benvonhandorf/RX_EQ_Shield/RX EQ Shield.kicad_pcb

## KiCad design RX EQ Shield.kicad_pcb (2022-07-02)

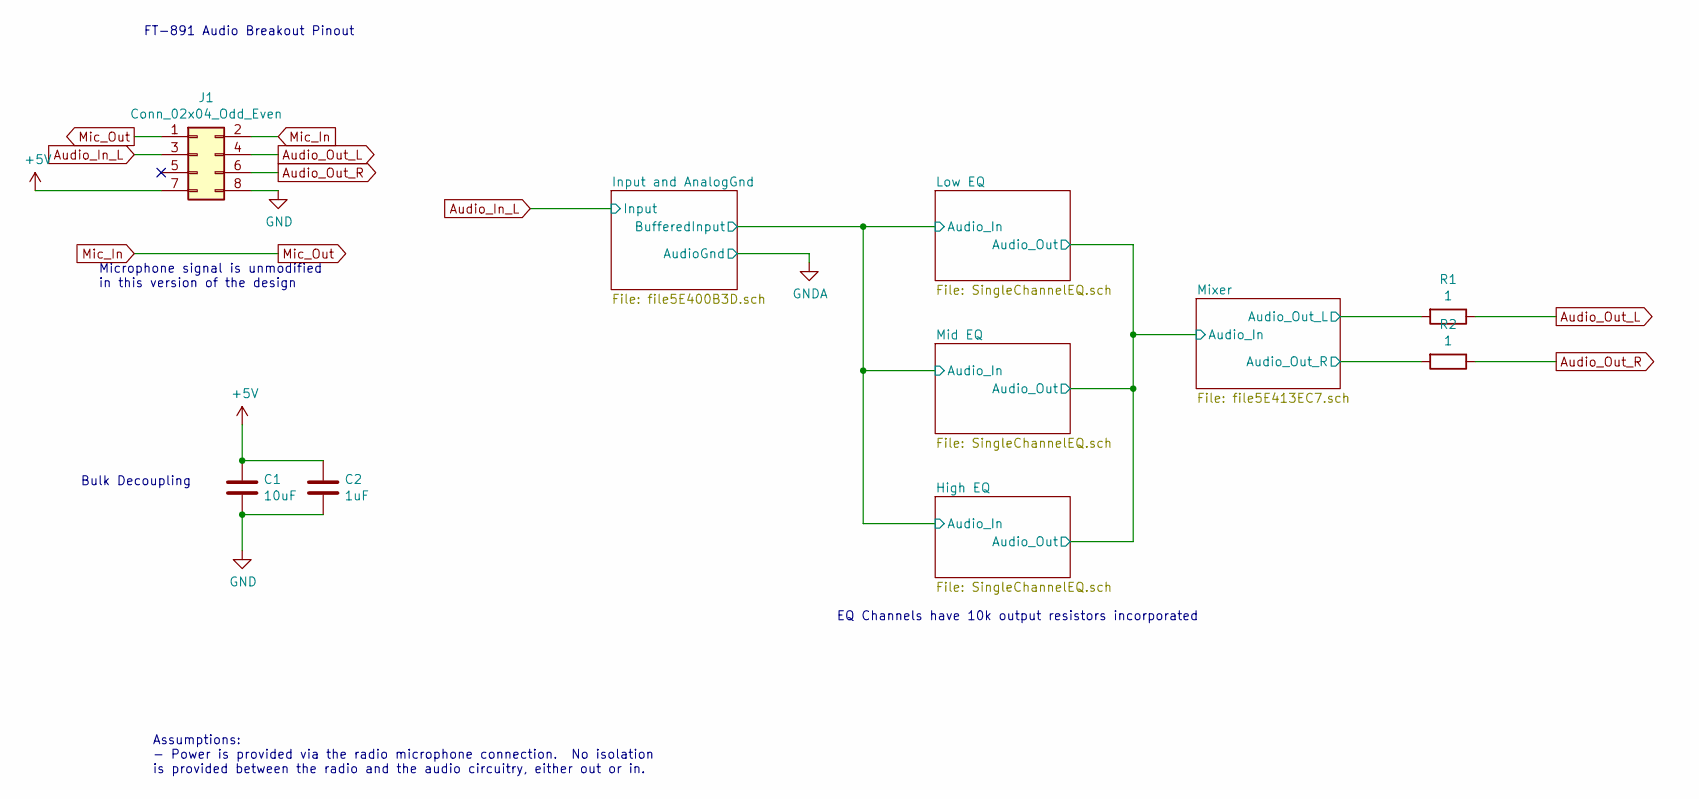
[picture p1: schematic RX EQ Shield.sch, FT-891 Audio breakout - 3 Band EQ Shield]

Parts:
C1: 10uF; C_0805_HandSoldering
C2: 1uF; C_0805_HandSoldering
J1: Conn_02x04_Odd_Even; Pin_Header_Straight_2x04_Pitch2.54mm
R1, R2: 1; R_0805_HandSoldering

Connections:
+5V: C1.1, C2.1, J1.7; also elsewhere on the board
Audio_In_L: J1.3; also elsewhere on the board
Audio_Out_L: J1.4, R1.1
Audio_Out_R: J1.6, R2.1
Mic_In: J1.1, J1.2

Notes on the sheet:
Bulk Decoupling
FT-891 Audio Breakout Pinout
Assumptions: - Power is provided via the radio microphone connection. No isolation is provided between the radio and the audio circuitry, either out or in.
EQ Channels have 10k output resistors incorporated
Microphone signal is unmodified in this version of the design

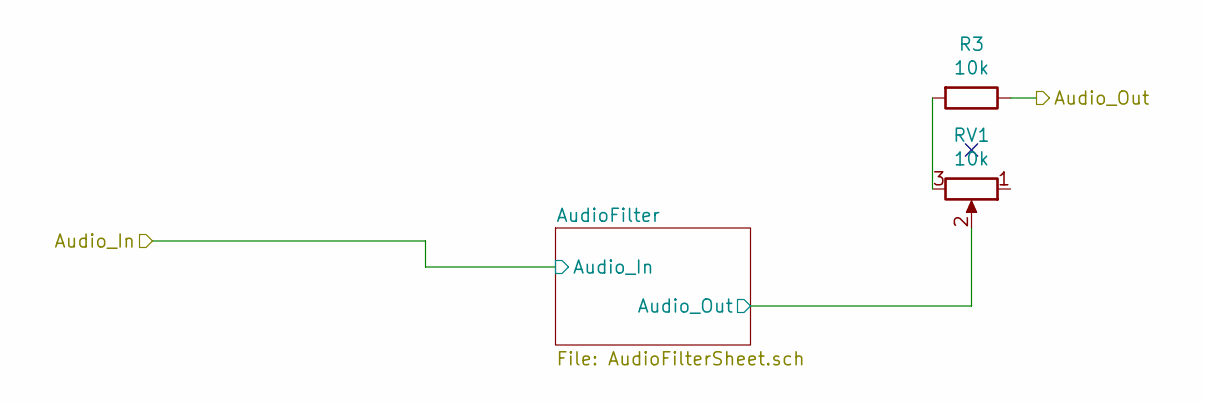
[picture p2: schematic SingleChannelEQ.sch, FT-891 Audio breakout - 3 Band EQ Shield]

Parts:
R3: 10k; R_0805_HandSoldering
RV1: 10k; Potentiometer_TT_P090S-Top-Adjust

Connections:
/Low EQ/AudioFilter/Audio_Out: RV1.2; also elsewhere on the board
/Mixer/Audio_In: R3.1; also elsewhere on the board
unnamed: R3.2, RV1.3

Parts of its further copies:
R7, R8: 10k; R_0805_HandSoldering
RV2, RV3: 10k; Potentiometer_TT_P090S-Top-Adjust

Connections of its further copies:
/High EQ/AudioFilter/Audio_Out: RV3.2; also elsewhere on the board
/Mid EQ/AudioFilter/Audio_Out: RV2.2; also elsewhere on the board
/Mixer/Audio_In: R7.1, R8.1; also elsewhere on the board
unnamed: R7.2, RV2.3
unnamed: R8.2, RV3.3

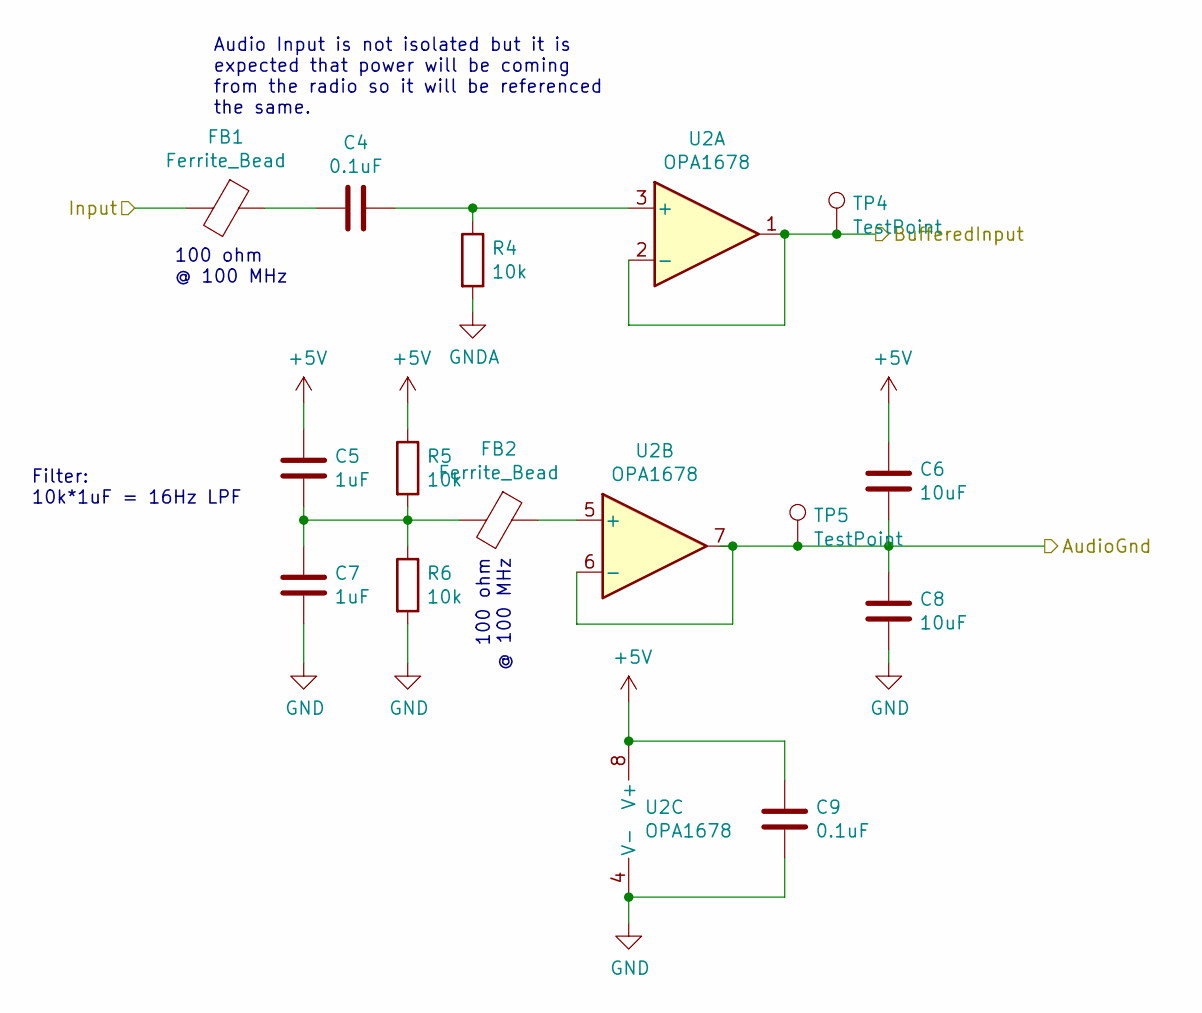
[picture p3: schematic file5E400B3D.sch, FT-891 Audio breakout - 3 Band EQ Shield]

Parts:
C4, C9: 0.1uF; C_0805_HandSoldering
C5, C7: 1uF; C_0805_HandSoldering
C6, C8: 10uF; C_0805_HandSoldering
FB1, FB2: Ferrite_Bead; L_0805_HandSoldering
R4, R5, R6: 10k; R_0805_HandSoldering
TP4, TP5: TestPoint; Test_Point_Keystone_5000-5004_Miniature
U2: OPA1678; SOIC-8-N

Connections:
+5V: C5.1, C6.1, C9.1, R5.1, U2.8 (V+); also elsewhere on the board
/High EQ/Audio_In: TP4.1, U2.1, U2.2 (-); also elsewhere on the board
Audio_In_L: FB1.2; also elsewhere on the board
GNDA: C6.2, C8.1, R4.2, TP5.1, U2.6 (-), U2.7; also elsewhere on the board
unnamed: C4.1, R4.1, U2.3 (+)
unnamed: C4.2, FB1.1
unnamed: C5.2, C7.1, FB2.2, R5.2, R6.1
unnamed: FB2.1, U2.5 (+)

Notes on the sheet:
Filter: 10k*1uF = 16Hz LPF
Audio Input is not isolated but it is expected that power will be coming from the radio so it will be referenced the same.
100 ohm @ 100 MHz

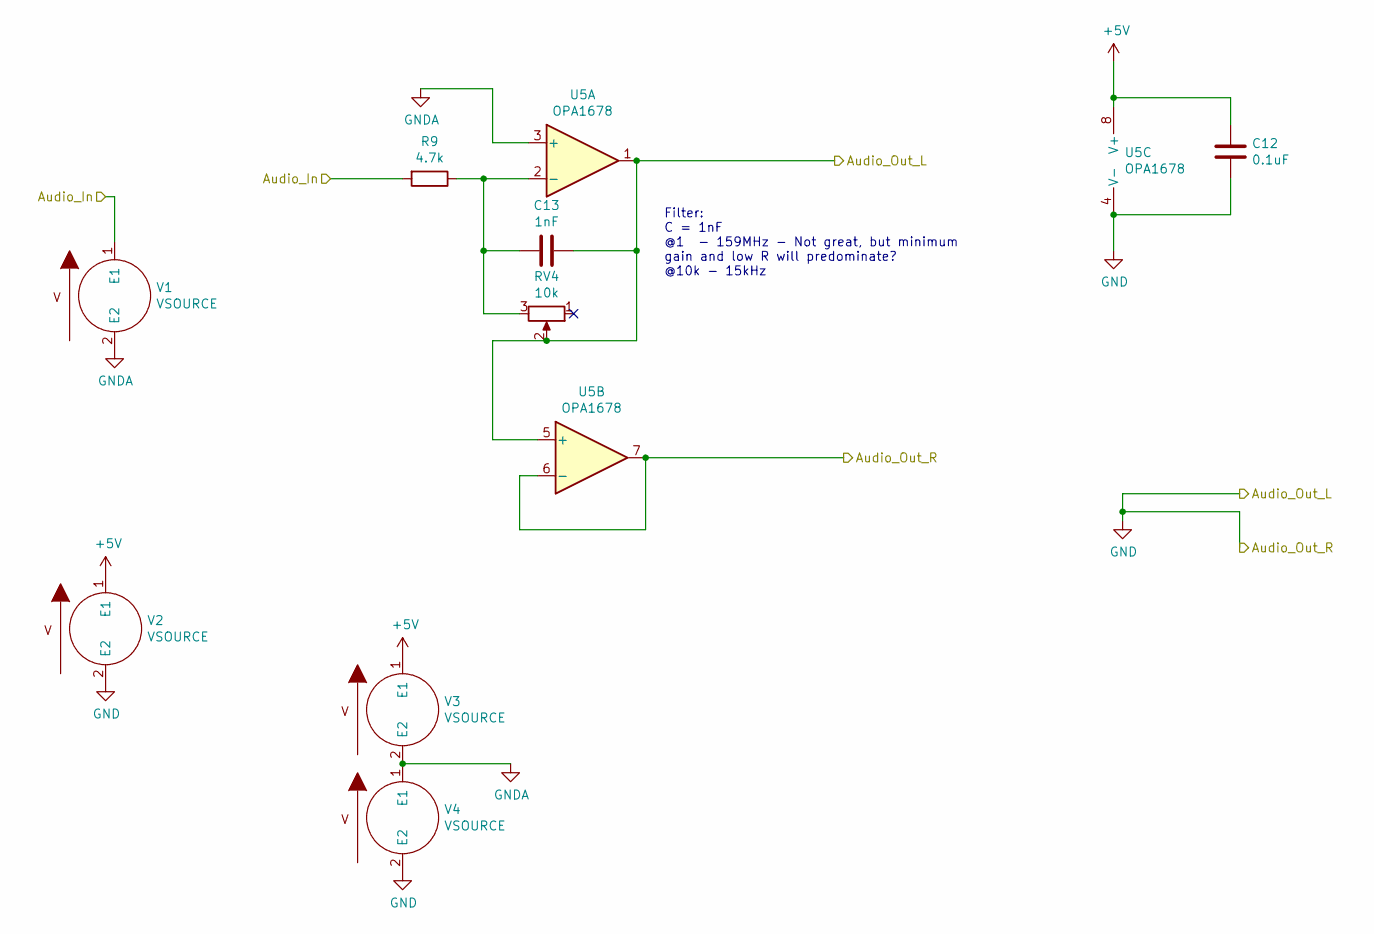
[picture p4: schematic file5E413EC7.sch, FT-891 Audio breakout - 3 Band EQ Shield]

Parts:
C12: 0.1uF; C_0805_HandSoldering
C13: 1nF; C_0805_HandSoldering
R9: 4.7k; R_0805_HandSoldering
RV4: 10k; Potentiometer_TT_P090S-Top-Adjust
U5: OPA1678; SOIC-8-N
V1, V2, V3, V4: VSOURCE

Connections:
+5V: C12.1, U5.8 (V+), V2.1 (E1), V3.1 (E1); also elsewhere on the board
/Mixer/Audio_In: R9.2, V1.1 (E1); also elsewhere on the board
GNDA: U5.3 (+), V1.2 (E2), V3.2 (E2), V4.1 (E1); also elsewhere on the board
unnamed: C13.2, R9.1, RV4.3, U5.2 (-)

Notes on the sheet:
Filter: C = 1nF @1 - 159MHz - Not great, but minimum gain and low R will predominate? @10k - 15kHz

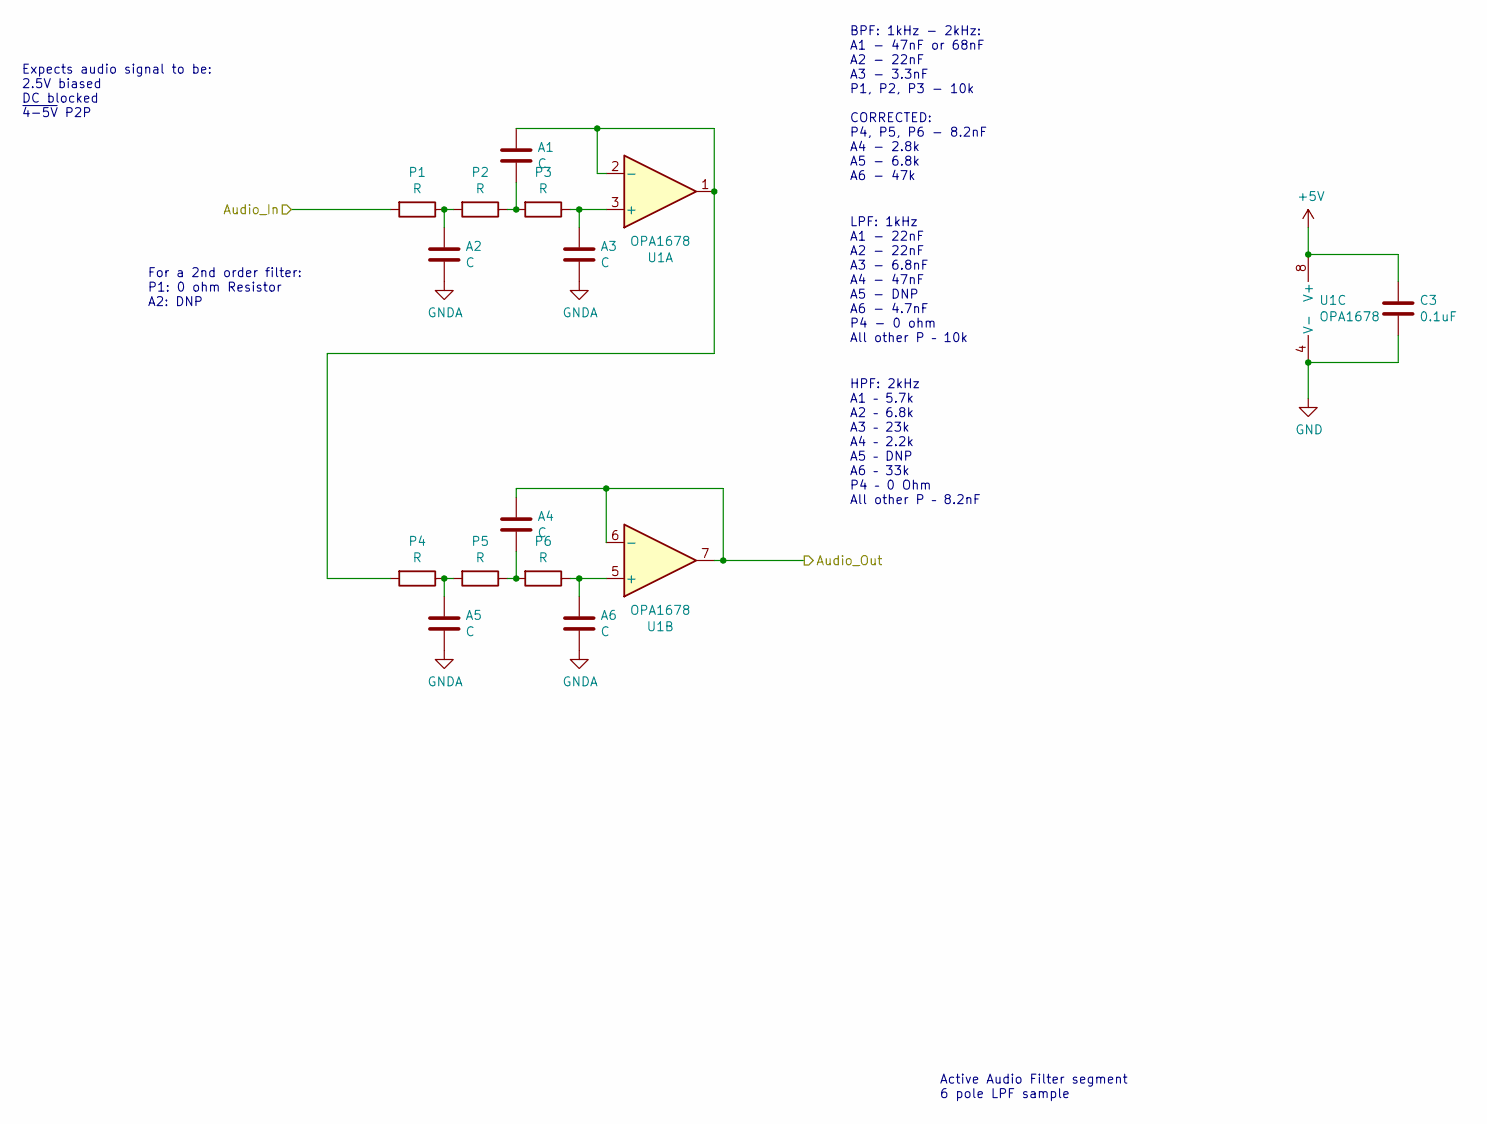
[picture p5: schematic AudioFilterSheet.sch, FT-891 Audio breakout - 3 Band EQ Shield]

Parts:
A1, A2, A3, A4, A5, A6: C; C_0805_HandSoldering
C3: 0.1uF; C_0805_HandSoldering
P1, P2, P3, P4, P5, P6: R; C_0805_HandSoldering
U1: OPA1678; SOIC-8-N

Connections:
+5V: C3.1, U1.8 (V+); also elsewhere on the board
/High EQ/Audio_In: P1.2; also elsewhere on the board
/Low EQ/AudioFilter/Audio_Out: A4.1, U1.6 (-), U1.7; also elsewhere on the board
GNDA: A2.2, A3.2, A5.2, A6.2; also elsewhere on the board
unnamed: A1.1, P4.2, U1.1, U1.2 (-)
unnamed: A1.2, P2.1, P3.2
unnamed: A2.1, P1.1, P2.2
unnamed: A3.1, P3.1, U1.3 (+)
unnamed: A4.2, P5.1, P6.2
unnamed: A5.1, P4.1, P5.2
unnamed: A6.1, P6.1, U1.5 (+)

Parts of its further copies:
A7, A8, A9, A10, A11, A12, A13, A14, A15, A16, A17, A18: C; C_0805_HandSoldering
C10, C11: 0.1uF; C_0805_HandSoldering
P7, P8, P9, P10, P11, P12, P13, P14, P15, P16, P17, P18: R; C_0805_HandSoldering
U3, U4: OPA1678; SOIC-8-N

Connections of its further copies:
+5V: C10.1, C11.1, U3.8 (V+), U4.8 (V+); also elsewhere on the board
/High EQ/AudioFilter/Audio_Out: A16.1, U4.6 (-), U4.7; also elsewhere on the board
/High EQ/Audio_In: P7.2, P13.2; also elsewhere on the board
/Mid EQ/AudioFilter/Audio_Out: A10.1, U3.6 (-), U3.7; also elsewhere on the board
GNDA: A8.2, A9.2, A11.2, A12.2, A14.2, A15.2, A17.2, A18.2; also elsewhere on the board
unnamed: A7.1, P10.2, U3.1, U3.2 (-)
unnamed: A7.2, P8.1, P9.2
unnamed: A8.1, P7.1, P8.2
unnamed: A9.1, P9.1, U3.3 (+)
unnamed: A10.2, P11.1, P12.2
unnamed: A11.1, P10.1, P11.2
unnamed: A12.1, P12.1, U3.5 (+)
unnamed: A13.1, P16.2, U4.1, U4.2 (-)
unnamed: A13.2, P14.1, P15.2
unnamed: A14.1, P13.1, P14.2
unnamed: A15.1, P15.1, U4.3 (+)
unnamed: A16.2, P17.1, P18.2
unnamed: A17.1, P16.1, P17.2
unnamed: A18.1, P18.1, U4.5 (+)

Notes on the sheet:
Active Audio Filter segment 6 pole LPF sample
Expects audio signal to be: 2.5V biased DC blocked ~4-5V P2P
For a 2nd order filter: P1: 0 ohm Resistor A2: DNP
BPF: 1kHz - 2kHz: A1 - 47nF or 68nF A2 - 22nF A3 - 3.3nF P1, P2, P3 - 10k CORRECTED: P4, P5, P6 - 8.2nF A4 - 2.8k A5 - 6.8k A6 - 47k
LPF: 1kHz A1 - 22nF A2 - 22nF A3 - 6.8nF A4 - 47nF A5 - DNP A6 - 4.7nF P4 - 0 ohm All other P – 10k
HPF: 2kHz A1 – 5.7k A2 – 6.8k A3 – 23k A4 – 2.2k A5 – DNP A6 – 33k P4 – 0 Ohm All other P – 8.2nF

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
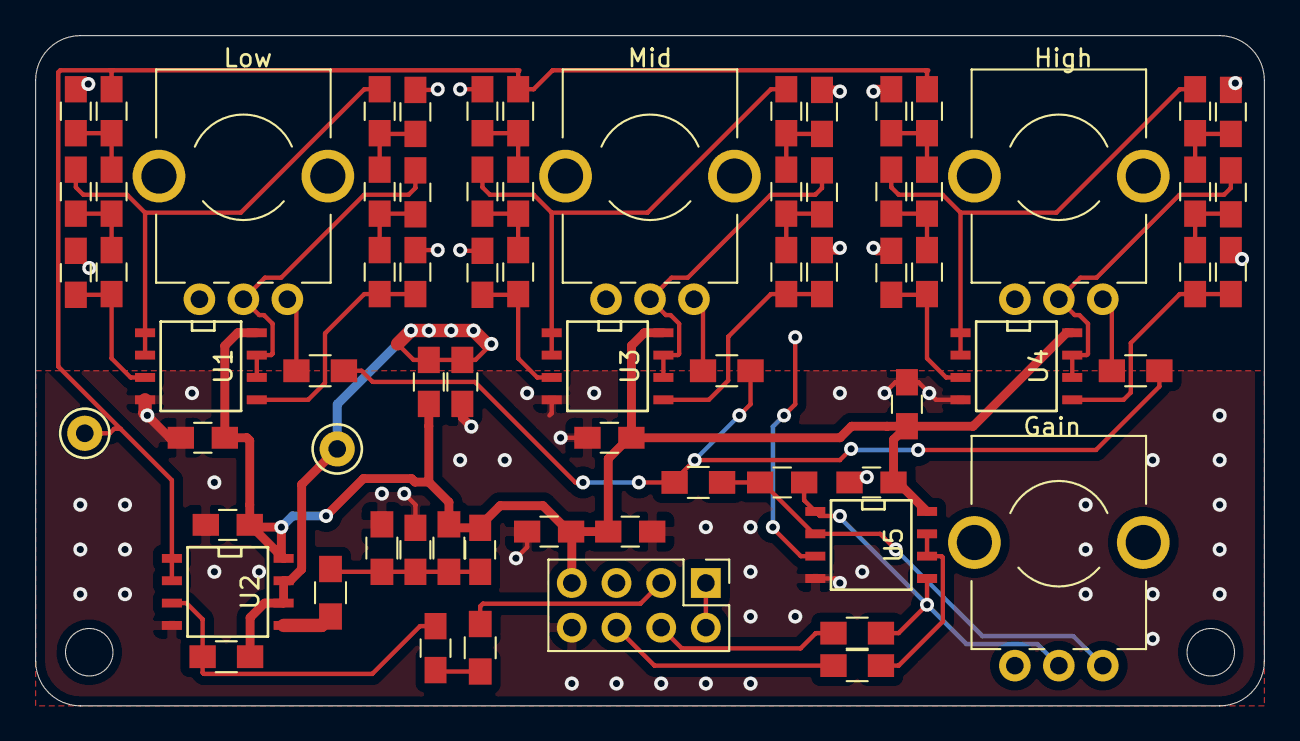
[picture p6: board RX EQ Shield.kicad_pcb from above]

Board: 2 copper layers, 69.8 x 38.1 mm, 72 parts (0 on the bottom side), 43 nets.
