benvonhandorf/RX_EQ_Shield/(commit log)

2020-02-10 WIP - Initial schematics
    [AudioFilterSheet.sch, RX EQ Shield.kicad_pcb, RX EQ Shield.sch, SingleChannelEQ.sch, file5E400B3D.sch, file5E413EC7.sch]
2020-02-13 Filter calculations, gain stage, oscillation protection
    [AudioFilterSheet.sch, RX EQ Shield.sch, SingleChannelEQ.sch, file5E413EC7.sch]
2020-05-17 Ferrite beads and annotations
    [AudioFilterSheet.sch, RX EQ Shield.sch, SingleChannelEQ.sch, file5E400B3D.sch, file5E413EC7.sch]
2020-05-17 Layout, 2020-05 order
    [AudioFilterSheet.sch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]
2020-06-02 Faceplate WIP
    [RX EQ Shield - Faceplate.kicad_pcb, RX EQ Shield - Faceplate.sch]
2020-06-02 Faceplate ordered
    [RX EQ Shield - Faceplate-B_Cu.gbr, RX EQ Shield - Faceplate-B_Mask.gbr, RX EQ Shield - Faceplate-B_Paste.gbr, RX EQ Shield - Faceplate-B_SilkS.gbr, RX EQ Shield - Faceplate-Edge_Cuts.gbr, RX EQ Shield - Faceplate-F_Cu.gbr, RX EQ Shield - Faceplate-F_Mask.gbr, RX EQ Shield - Faceplate-F_Paste.gbr]
